oran-srfr/stm32-xunji-car-yantouyu/STM32小车开源芋头雨/元素思路.pdf

## STM32 小车开源代码使用说明

作者：b 站芋头雨- 日期：2025.5.27

声明：

此代码参考了江科大的部分模块代码，龙邱科技的差速部分，欢迎大家随

意修改学习传播，但不得作为商业用途！

一、 整体框架

基础模块搭建：

1、 | oled 屏幕显示：用于循迹调参、状态位显示
2、 | i2c 以及陀螺仪：用于辅助转向以及元素处理
3、 | 编码器、pwm：用于控制轮子输出 pwm 闭环控制转速
4、 | 传感器：及灰度传感器，用于识别黑线，循迹
5、 | 其他：串口、按键：辅助观察参数、闭环辅助等

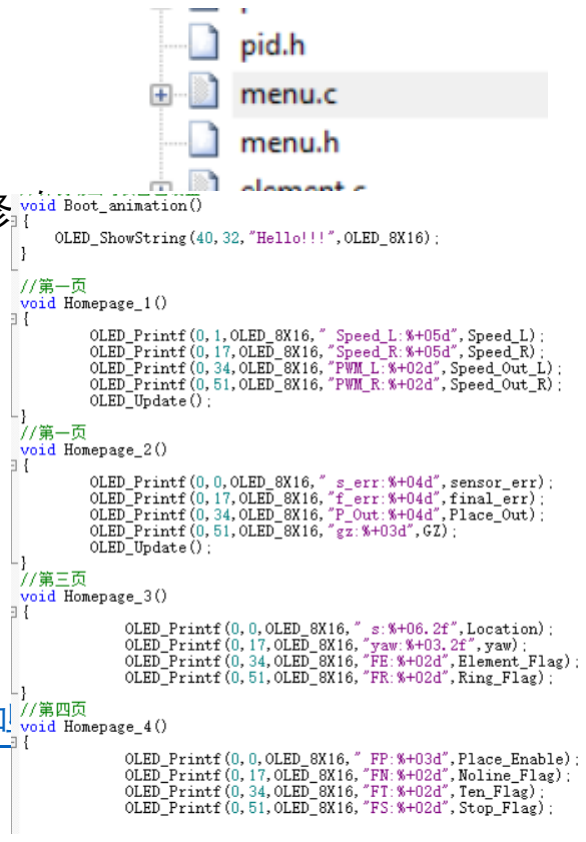
[picture p8: figure]

6、 | 菜单：很基础的菜单，大家只需要在这些函数里面修改
| 参数即可，其他无需修改。（按键引脚要改一下
| ，不然无法翻页）

参考教程：STM32 入门教程-2023 版 细致讲解 中文字幕_哔哩哔哩_bilibili (https://www.bilibili.com/video/BV1th411z7sn/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)

陀螺仪：10-3 软件读取 mpu6050

PID 入门教程-电机控制 倒立摆 全程手把手打代码调试_哔哩哔哩_bilibili (https://www.bilibili.com/video/BV1G9zdYQEr3/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)

基础驱动编写以及调试：1-1~1-3

二、 控制部分

1、循迹：

原理：五路传感器默认低电平，灯亮，黑线无反射，灯灭。我们给五路

传感器分别乘上不同的值，以此代表偏离直线的多少。

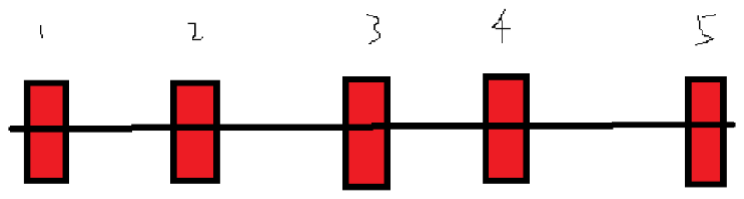
[picture p9: figure]

例如：

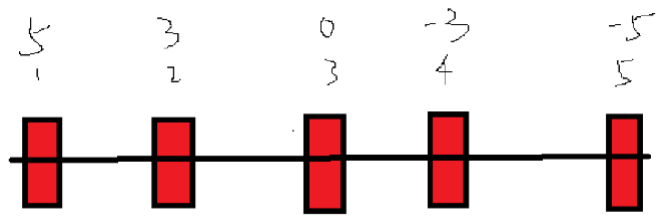
[picture p10: figure]

加权重：

有偏移：

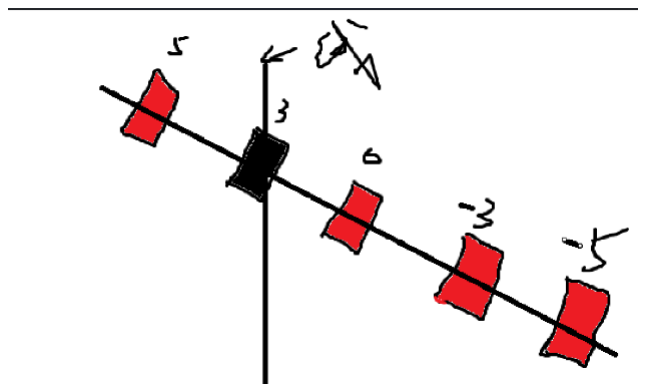
[picture p11: figure]

这时：如果我们使用一个 err=5*L2+3*L1+0*M-3*R1-5*R2

那我们就可以得到一个随位置变化而变化的 err 值了

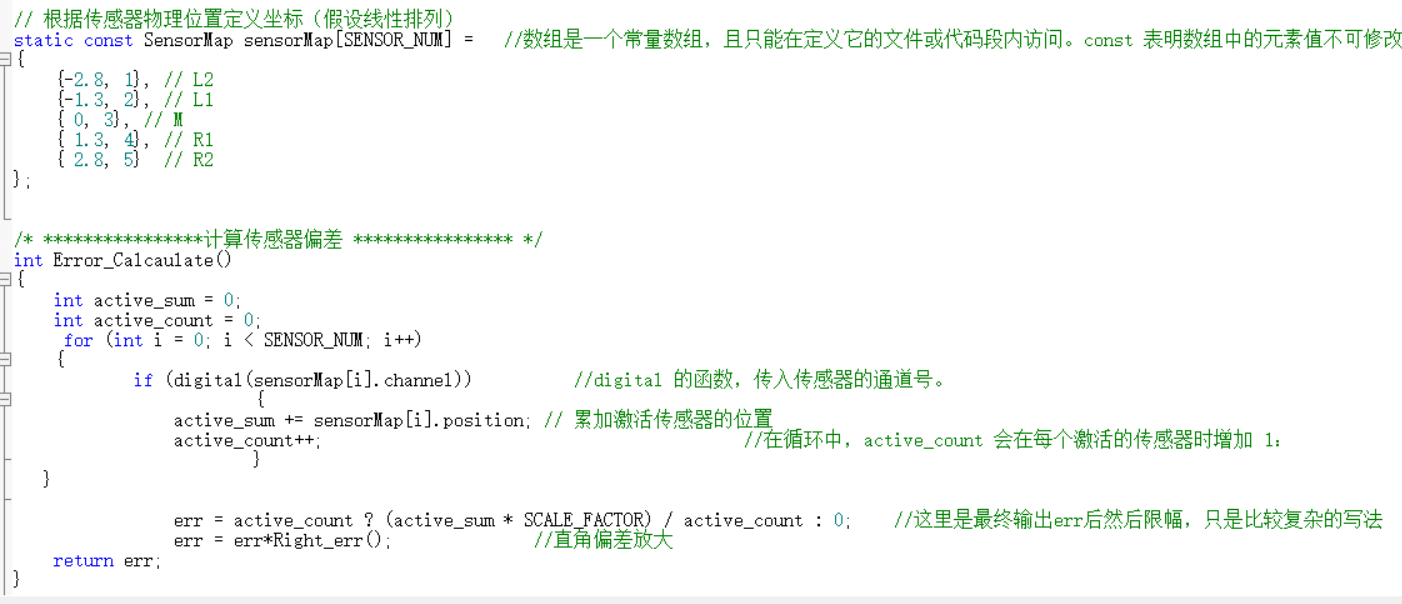
[picture p12: figure]

也就是这一段看似复杂的代码实际上在干的事情。只不过用了遍历和结

构体。

2、陀螺仪辅助循迹

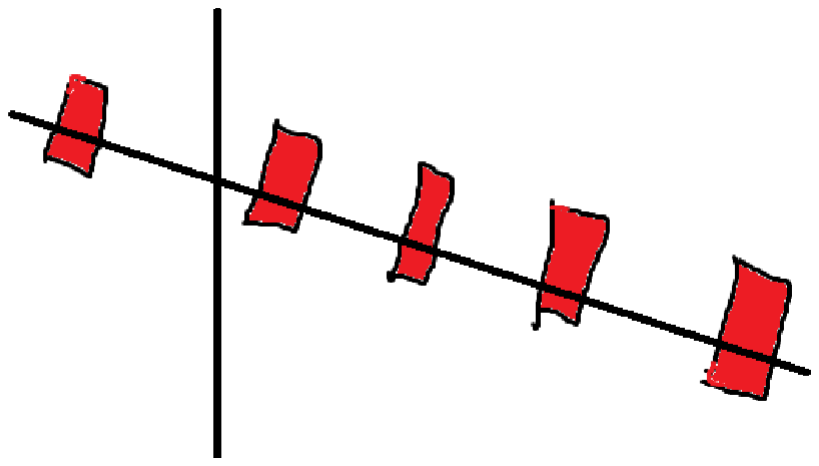
[picture p13: figure]

我们在实际调节过程中可能会发现在传感器之间存在一些空隙导致无法

正常控制，如果给他保存上一个值的话就出现了 5-3-0-3-5 这样阶跃的过

程，也就是在 5-3 不是线性变化的，这样会导致控制不够丝滑。最后我发

现用陀螺仪可以解决这个问题。

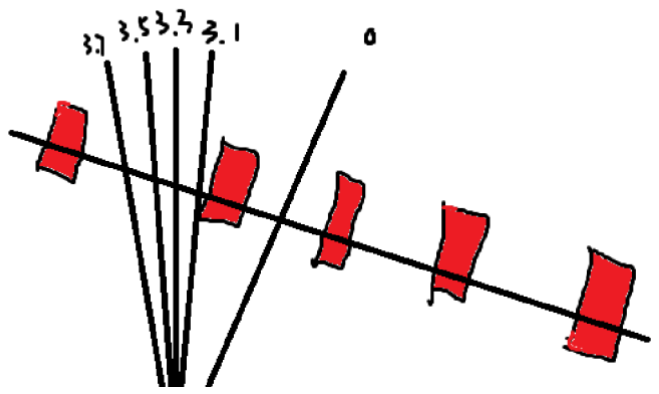
[picture p14: figure]

我们假设车身中间为 0°，只要我们通过转换，使得在两个传感器之间

的值是我们期望的，3.1，3.3，3.5，3.7 这样。而陀螺仪的变化又是线性的，那

不就弥补了这空缺无法线性变化的缺点了吗。

于是我们就可以得到 5-3.7-3.5-3.3……3.1-0 这样的 err。这样的 err 看

起来就舒服多了。

所以：先做积分处理，并根据期望的值做出相应的放大减小。

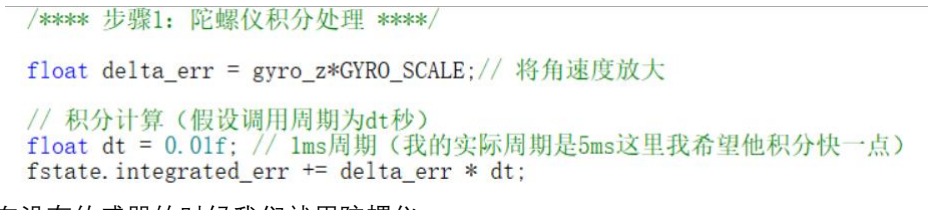
[picture p15: figure]

在没有传感器的时候我们就用陀螺仪：

另外：MPU6050 存在积分有误差的现象，因此我们每次有传感器经过时给他重

置一下积分，这样积分的误差就在可接受的范围内被不断刷新。

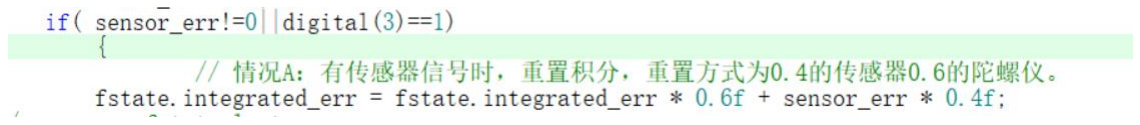
[picture p16: figure]

在有传感器的时候：

我们用一部分传感器算出来的误差一部分陀螺仪算出来的误差，也就是互补滤

波，通过调节系数可以到一个很好的状态。

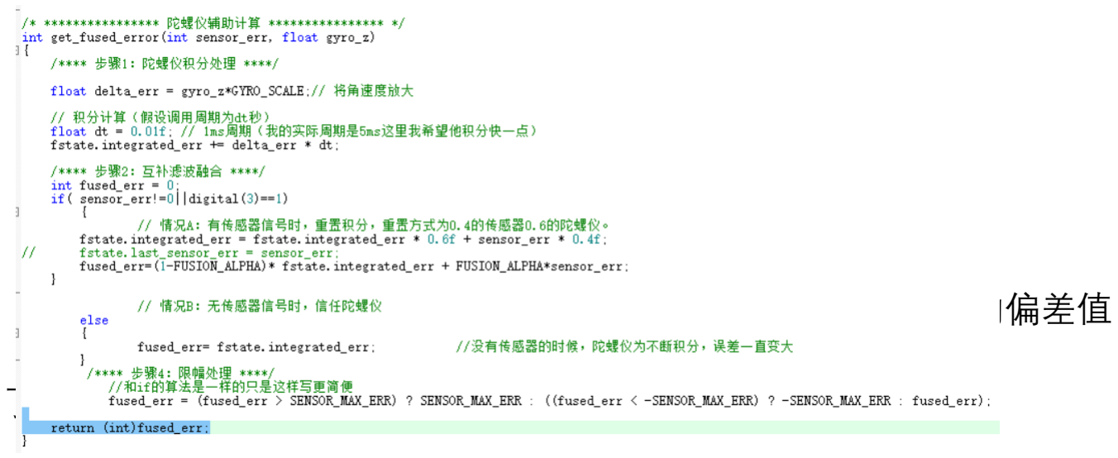
[picture p17: figure]
最后我们可以算出一个 fused_err。这就是我们最后要处理的偏差值

3、控制（转向环加速度环）

我们用的是串级，转向环的值会传递给速度环。所以我们需要先把速度

环调好。

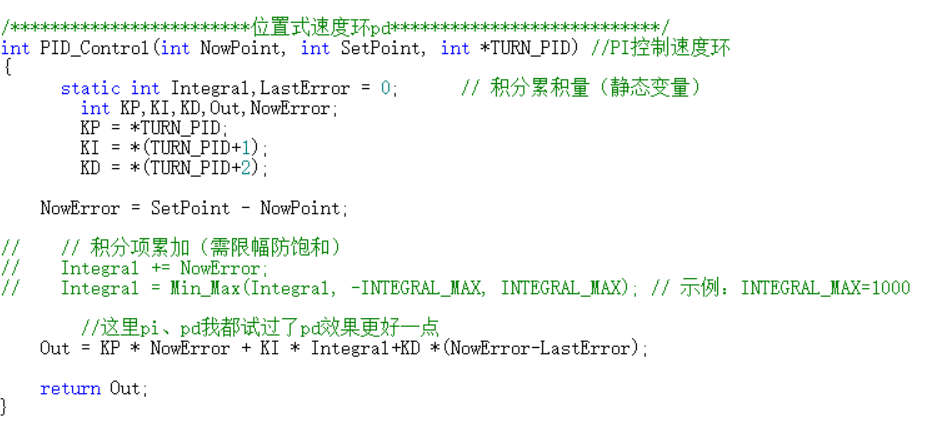
[picture p18: figure]

我们可以参考江科大的 pid 调参教程，将实际速度输入到

这样我们能通过串口显示的方式调出一个响应即使且不超调的图像

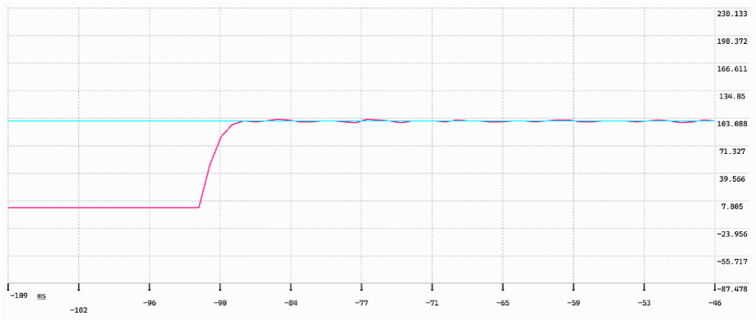
[picture p19: figure]

速度环调好之后，我们将转向环和速度环串在一起，

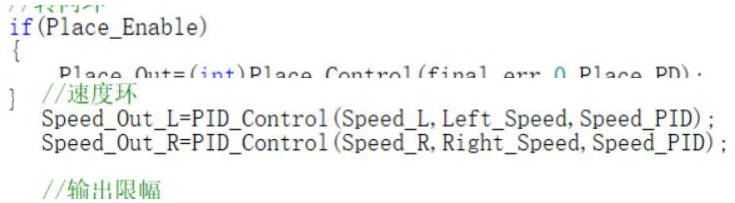
[picture p20: figure]

具体调试以及操作参考：

PID 入门教程-电机控制 倒立摆 全程手把手打代码调试_哔哩哔哩_bilibili (https://www.bilibili.com/video/BV1G9zdYQEr3/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)

1-4 集

4、关于差速计算（参考龙邱科技的开源方案）

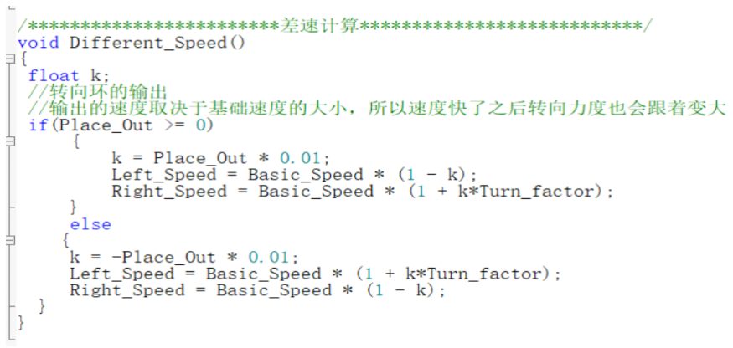
[picture p21: figure]

将转向环输出的值转换成 0~1 之间的数并×上目标速度，那么转向的力度会随

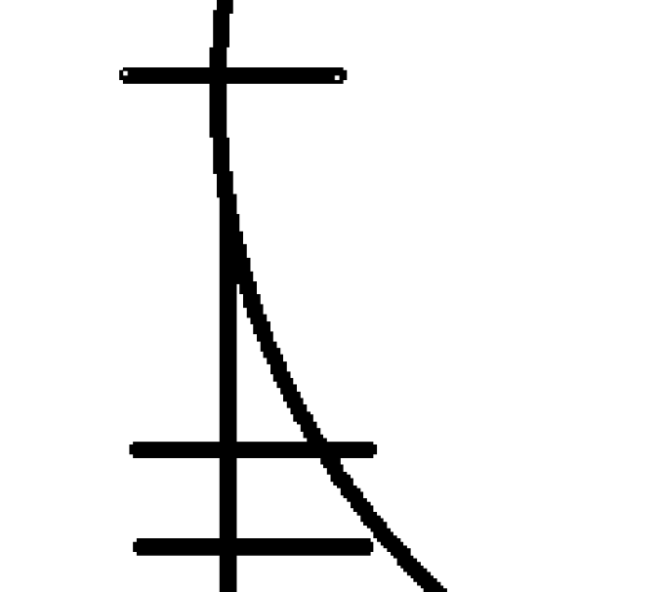
[picture p22: figure]

着基础速度提升而增加，pid 的适应性会增强。

三、 元素部分

1、 | 以圆环和断路为例：
| 圆环：
| 我们放大这个局部元素，就会发现从

进入圆环前到进入圆环中到进入圆环后灯有不同

的状态，根据不同的状态我们可以识别圆环。

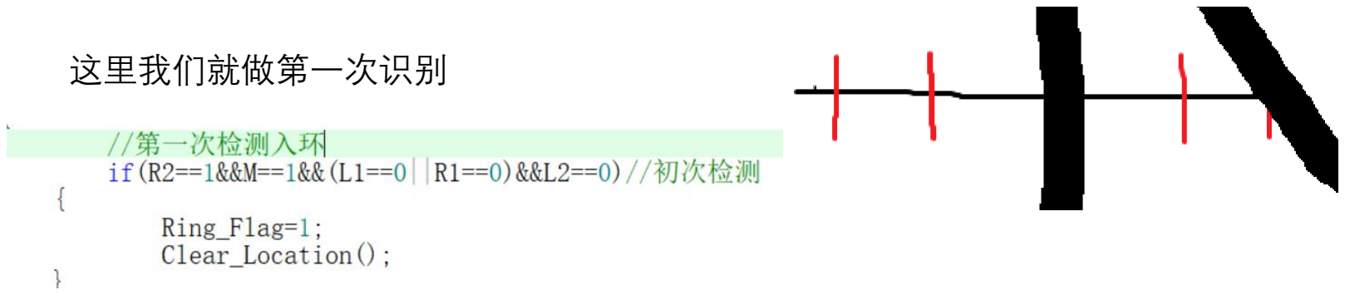
[picture p23: figure]
这里我们就做第一次识别
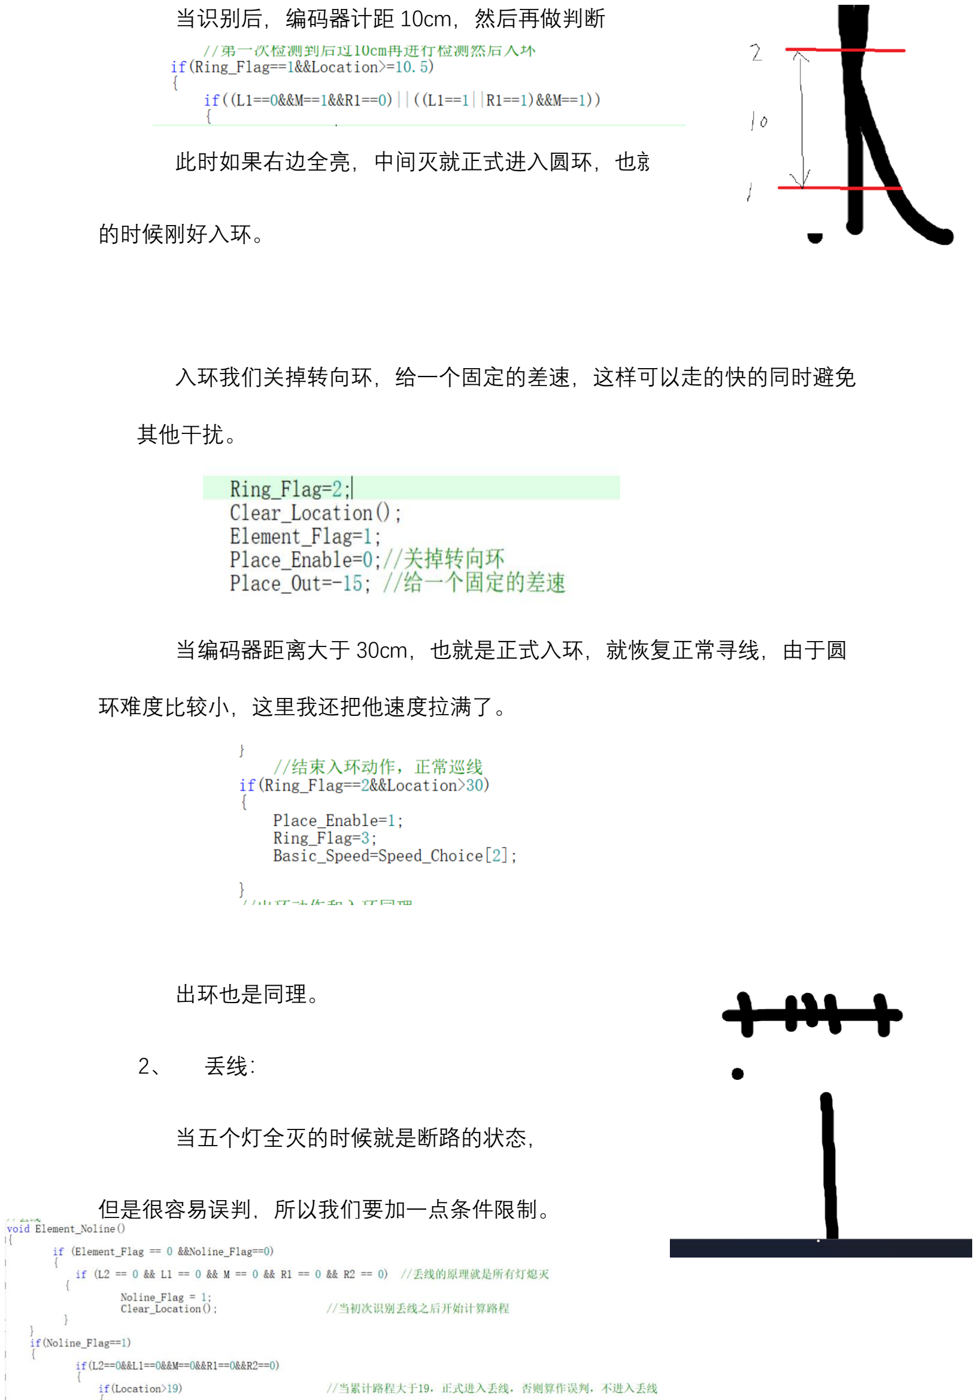
[picture p24: page 7]

当识别后，编码器计距 10cm，然后再做判断

此时如果右边全亮，中间灭就正式进入圆环，也就是在切线

的时候刚好入环。

入环我们关掉转向环，给一个固定的差速，这样可以走的快的同时避免

其他干扰。

当编码器距离大于 30cm，也就是正式入环，就恢复正常寻线，由于圆

环难度比较小，这里我还把他速度拉满了。

出环也是同理。

2、 | 丢线：
| 当五个灯全灭的时候就是断路的状态，

但是很容易误判，所以我们要加一点条件限制。

也就是灭一段距离后再次检测，如果仍然全灭进入判断，如果不是全灭那就清

零重计。

先加大幅度，转到想要的方向，然后通过距离判断转到哪里了，然后

给固定占空比直线走过去。

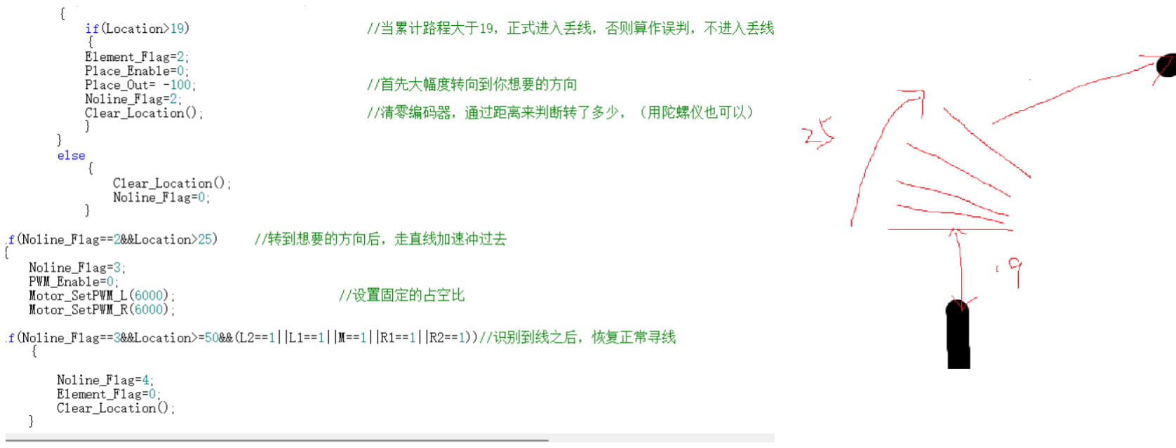
[picture p25: figure]

四、 注意事项

1、如果打开代码发现全是乱码将字体格式调为 GB2312 即可。

2、编码器参数不一定可以直接用，需要自己手推 1m 或者 2m，看一下总

共的编码器数值，在实际转换成自己对应的值。

3、如果有各种错误或者更好的意见，欢迎 b 站搜索芋头雨-跟我交流。
