oran-srfr/stm32-xunji-car-yantouyu/STM32小车开源芋头雨/硬件部分/结构建模/小车尺寸.png

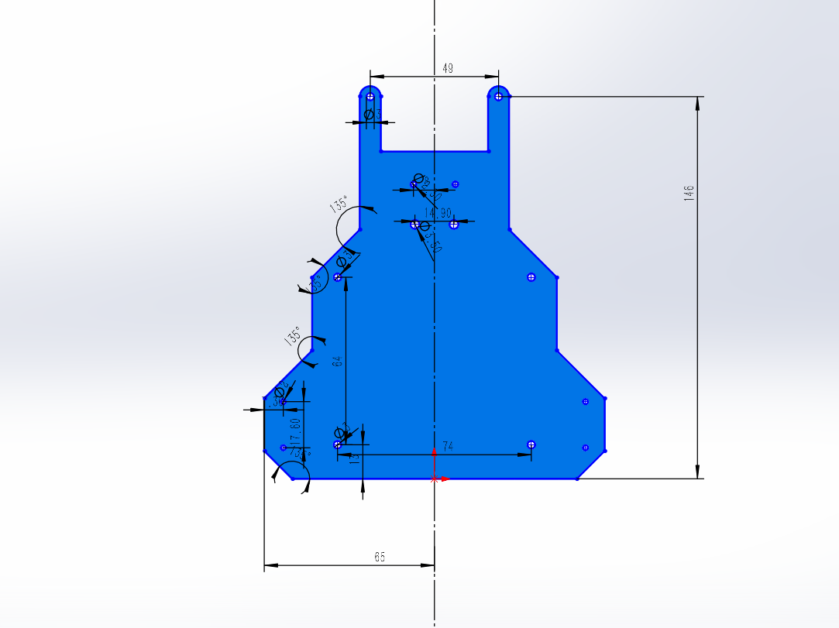
STM32小车开源芋头雨/硬件部分/结构建模/小车尺寸.png
