oran-srfr/stm32-xunji-car-yantouyu/STM32小车开源芋头雨/硬件部分/结构建模/商家打印文件/底板.STL

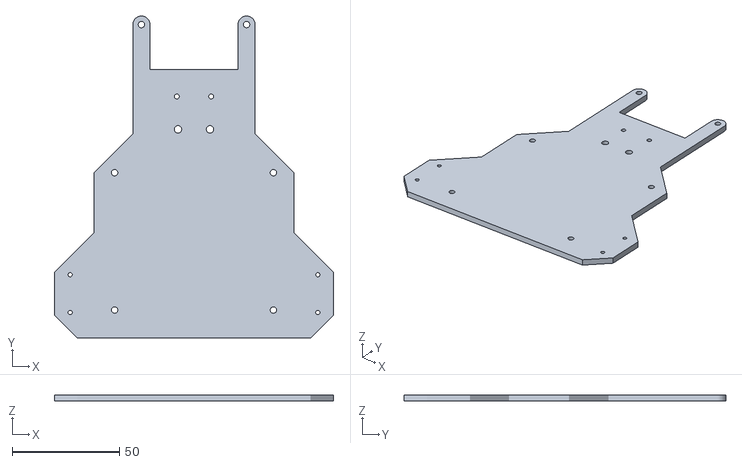
[picture p27: CAD file, 2026-11-01]
STM32小车开源芋头雨/硬件部分/结构建模/商家打印文件/底板.STL
130.0 x 150.0 x 3.00
