oran-srfr/stm32-xunji-car-yantouyu/STM32小车开源芋头雨/硬件部分/结构建模/小底板.SLDPRT

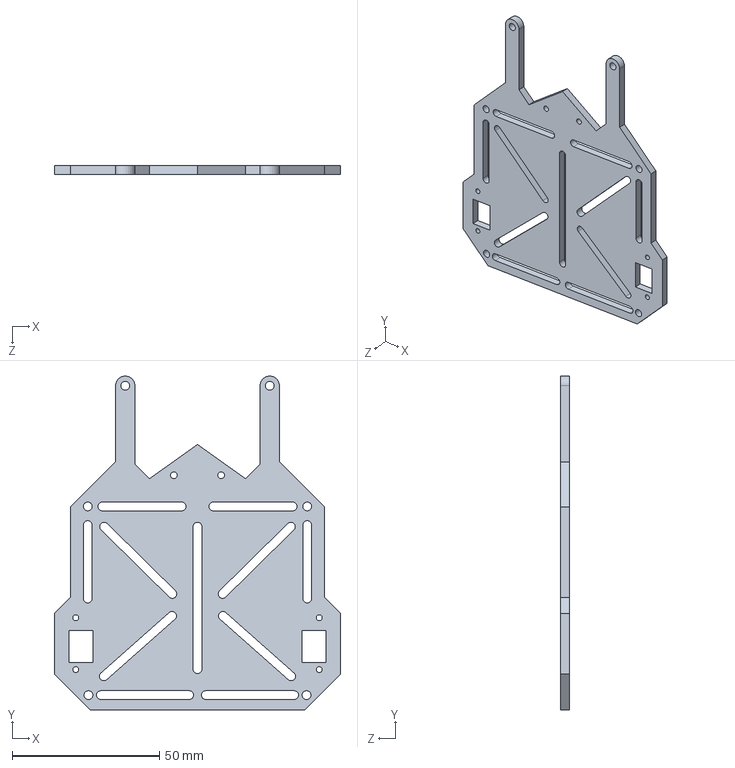
[picture p28: CAD file, 2026-11-01]
STM32小车开源芋头雨/硬件部分/结构建模/小底板.SLDPRT
97.2 x 113.3 x 3.00 mm
