oran-srfr/stm32-xunji-car-yantouyu/STM32小车开源芋头雨/硬件部分/结构建模/超声波板框.SLDPRT

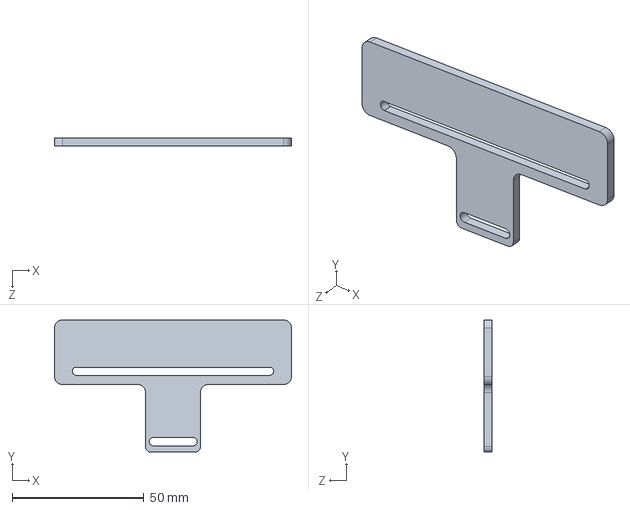
[picture p29: CAD file, 2026-11-01]
STM32小车开源芋头雨/硬件部分/结构建模/超声波板框.SLDPRT
90.0 x 50.1 x 3.00 mm
