oran-srfr/stm32-xunji-car-yantouyu/STM32小车开源芋头雨/硬件部分/结构建模/加长前瞻.SLDPRT

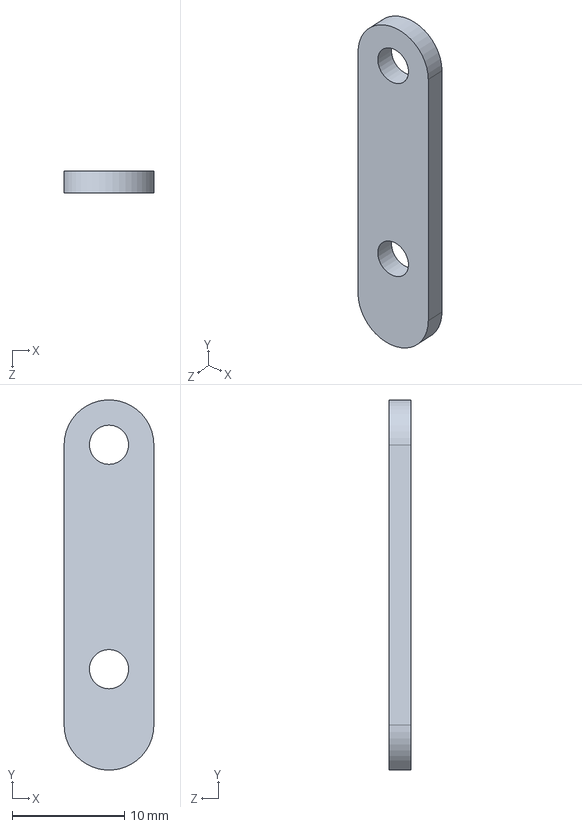
[picture p30: CAD file, 2026-11-01]
STM32小车开源芋头雨/硬件部分/结构建模/加长前瞻.SLDPRT
8.00 x 33.0 x 2.00 mm
