oran-srfr/stm32-xunji-car-yantouyu/(list of files, cad)

Other CAD files:
STM32小车开源芋头雨/硬件部分/结构建模/商家打印文件/标准底板.DWG
STM32小车开源芋头雨/硬件部分/结构建模/底板.SLDPRT
STM32小车开源芋头雨/硬件部分/结构建模/商家打印文件/底板.DXF
