oran-srfr/stm32-xunji-car-yantouyu/STM32小车开源芋头雨/stm32修改日志.pdf

# STM32小车的代码应用

1、修复了编码器测试中定时器有误导致测试无法正常进行的问题

2、修复了灰度传感器初始化引脚号有误的问题

3、增加了对于黑底白线赛道（蓝底白线赛道） 和 白底黑线赛道的选择

4 、修复了陀螺仪初始化失败，yaw无法显示，零漂过大的问题

5、修复了栈空间不足导致的初始化失败问题

6、修复了 速度环的误差更新问题

7、统一了误差的度量单位为角度更容易理解

8、更改了底板万向轮尺寸有误差导致无法正常安装的问题

9、增加了超声波避障的功能，提供了一个历程文件

10、增加了一个短小底板，适合更微缩的赛道使用

11、为了避免过于依赖陀螺仪，注释掉了陀螺仪的完全积分部分
