oran-srfr/stm32-xunji-car-yantouyu/STM32小车开源芋头雨/硬件部分/PCB/原理图.pdf

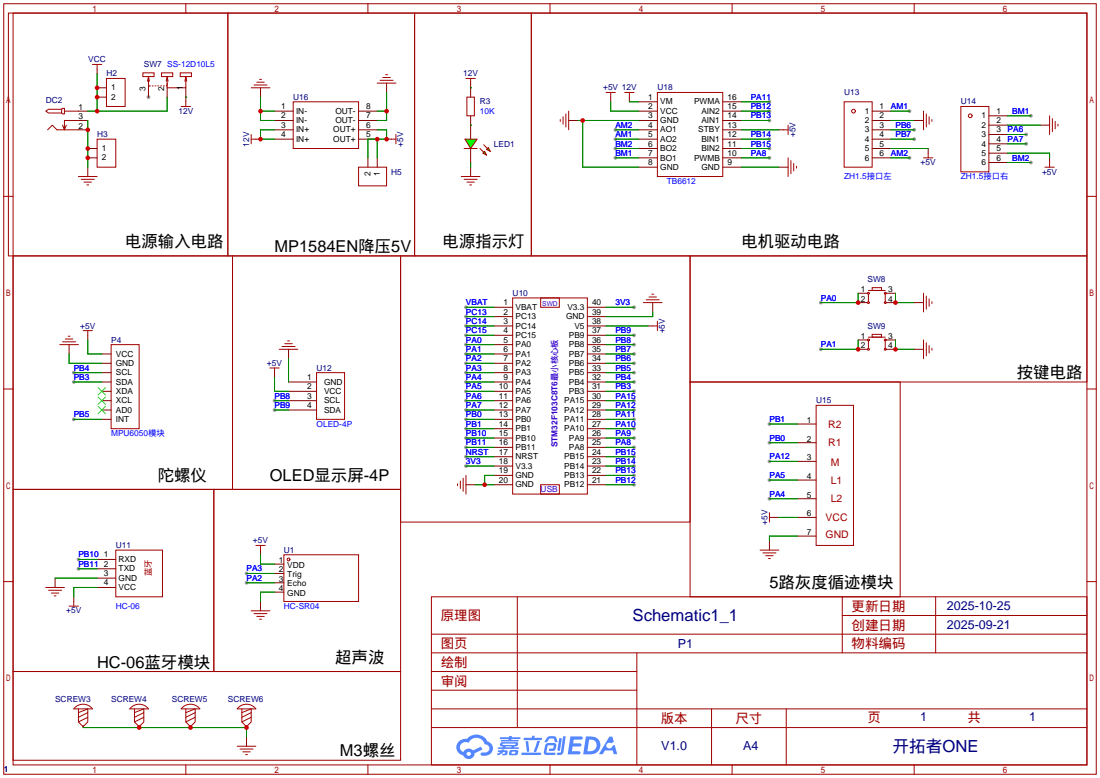
[picture p31: page 1]
