oran-srfr/stm32-xunji-car-yantouyu/(list of files, drawings)

Other design files:
STM32小车开源芋头雨/硬件部分/PCB/小车pcb.epro
