oran-srfr/stm32-xunji-car-yantouyu/STM32小车开源芋头雨/代码部分/基础版本（元素未开启）/User/main.c

/***************************************************************************************
  * 本程序由b站芋头雨-创建并免费开源共享
  * 你可以任意查看、使用和修改，并应用到自己的项目之中
  * 修改时间：2025 11 17 v2.0
  ***************************************************************************************
  */
  
#include "myfile.h"

/************************主函数***************************/
int main(void)
{
		MPU6050_Init();
		Serial_Init();
		Key_Init();		
		OLED_Init();
		Timer_Init();
		Encoder_Init(); 
		SENSOR_GPIO_Config(); //循迹引脚初始化
		Motor_Init();					//电机初始化
		PWM_Init();						//占空比定时器1初始化
		calibrate_gyro();  
	while (1)
	{		  		
		
			Key_Num = Key_GetNum();  	    
			menu_operation();																					//菜单调用函数
			Serial_Printf("%d,%f,%d,%f\r\n",sensor_err,final_err,Place_Out,0); //串口输出（自己修改变量打印到电脑上来调节速度环）
			OLED_Update();	
	}
}
/************************中断***************************/
void TIM2_IRQHandler(void)
{

	if (TIM_GetITStatus(TIM2, TIM_IT_Update) == SET)
	{			
		Control();      //控制函数（最主要的控制都在这里面） 
		Key_Tick();			//获取按键值，江科大的定时器非阻塞	
		TIM_ClearITPendingBit(TIM2, TIM_IT_Update);
	}
}
