oran-srfr/stm32-xunji-car-yantouyu/STM32小车开源芋头雨/代码部分/超声波避障版本/Hardware/Motor.c

#include "stm32f10x.h"                  // Device header
#include "PWM.h"

void Motor_Init(void)
{
	RCC_APB2PeriphClockCmd(RCC_APB2Periph_GPIOB, ENABLE);
	
	GPIO_InitTypeDef GPIO_InitStructure;
	GPIO_InitStructure.GPIO_Mode = GPIO_Mode_Out_PP;
	GPIO_InitStructure.GPIO_Pin = GPIO_Pin_12 | GPIO_Pin_13 | GPIO_Pin_14 | GPIO_Pin_15;
	GPIO_InitStructure.GPIO_Speed = GPIO_Speed_50MHz;
	GPIO_Init(GPIOB, &GPIO_InitStructure);
	
	PWM_Init();
}

void Motor_SetPWM_L(int16_t Duty)
{
			if (Duty >= 0)
		{
			GPIO_SetBits(GPIOB, GPIO_Pin_12);
			GPIO_ResetBits(GPIOB, GPIO_Pin_13);
			PWM_SetCompare4(Duty);
		}
		else
		{		
		    GPIO_SetBits(GPIOB, GPIO_Pin_13);
			GPIO_ResetBits(GPIOB, GPIO_Pin_12);	
			PWM_SetCompare4(-Duty);
		}

}

void Motor_SetPWM_R(int16_t Duty)
{
	if (Duty >= 0)
		{
			GPIO_SetBits(GPIOB, GPIO_Pin_15); 
			GPIO_ResetBits(GPIOB, GPIO_Pin_14);   
			PWM_SetCompare1(Duty);
		}
		else
		{		
		    GPIO_SetBits(GPIOB, GPIO_Pin_14);
			GPIO_ResetBits(GPIOB, GPIO_Pin_15);
			PWM_SetCompare1(-Duty);
		}	

}
