oran-srfr/stm32-xunji-car-yantouyu/STM32小车开源芋头雨/代码部分/基础版本（元素未开启）/Control/error.h

#ifndef __ERROR_H
#define	__ERROR_H

#include "sensor.h"	   
/*-------------数字端口----------------*/
float Error_Calcaulate(void);
extern int err;
float get_fused_error(float sensor_err, float gyro_z);
float Right_err(void);
float low_pass_filter(float input, float alpha);
#endif 
