oran-srfr/stm32-xunji-car-yantouyu/STM32小车开源芋头雨/代码部分/超声波避障版本/System/myfile.h

#ifndef __MYFILE_H
#define	__MYFILE_H

#include "stm32f10x.h"                  // Device header
#include "Delay.h"
#include "OLED.h"
#include "MyI2C.h"
#include "MPU6050.h"
#include "MPU6050_Reg.h"
#include "kalman.h"
#include "Motor.h"
#include "PWM.h"
#include "Timer.h"
#include "pid.h"
#include "Encoder.h"
#include "stm32f10x.h"                  // Device header
#include "Delay.h"
#include "OLED.h"
#include "sensor.h"
#include "error.h"
#include "key.h"
#include "myfile.h"
#include "menu.h"
#include "element.h"
#include <stdio.h>
#include <stdarg.h>
#include <math.h>
#include "Serial.h"
#include "ultrasonic.h"
#endif 
